wahudson/piezo_ac_drive/kicad/v5/v5.pdf

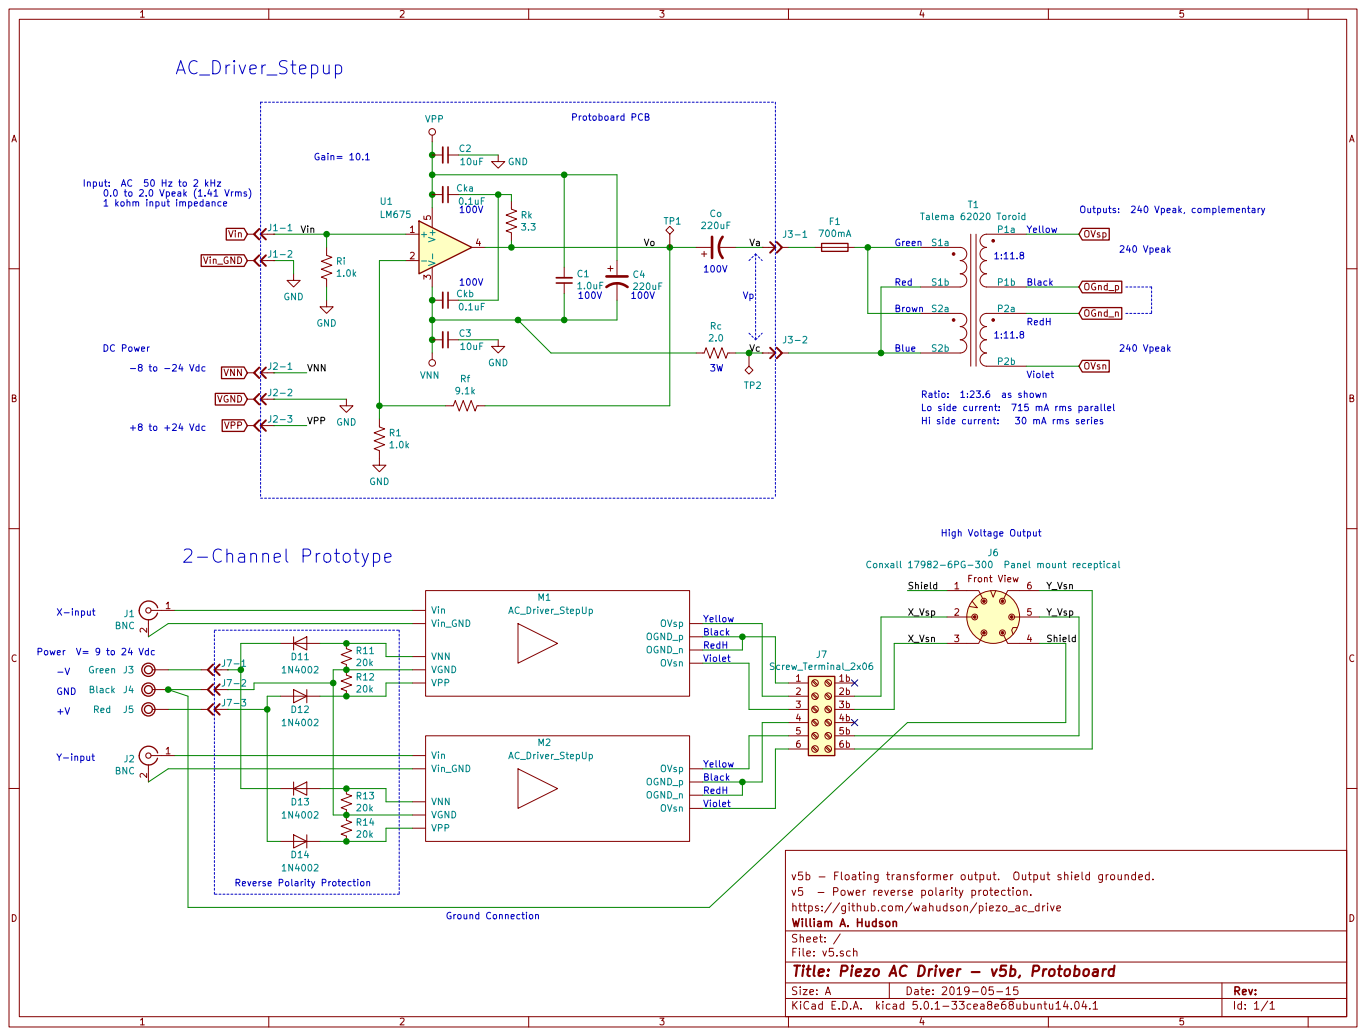
[picture p1: page 1]

Input: AC 50 Hz to 2 kHz
0.0 to 2.0 Vpeak (1.41 Vrms)
1 kohm input impedance

Violet Green Red Brown Blue Cka

Lo side current: 715 mA rms parallel

v5b - Floating transformer output. Output shield grounded.
v5 - Power reverse polarity protection.
https://github.com/wahudson/piezo_ac_drive
File: v5.sch Sheet: / William A. Hudson

Id: 1/1 Title: Piezo AC Driver - v5b, Protoboard
