wahudson/piezo_ac_drive/kicad/v4/v4.pdf

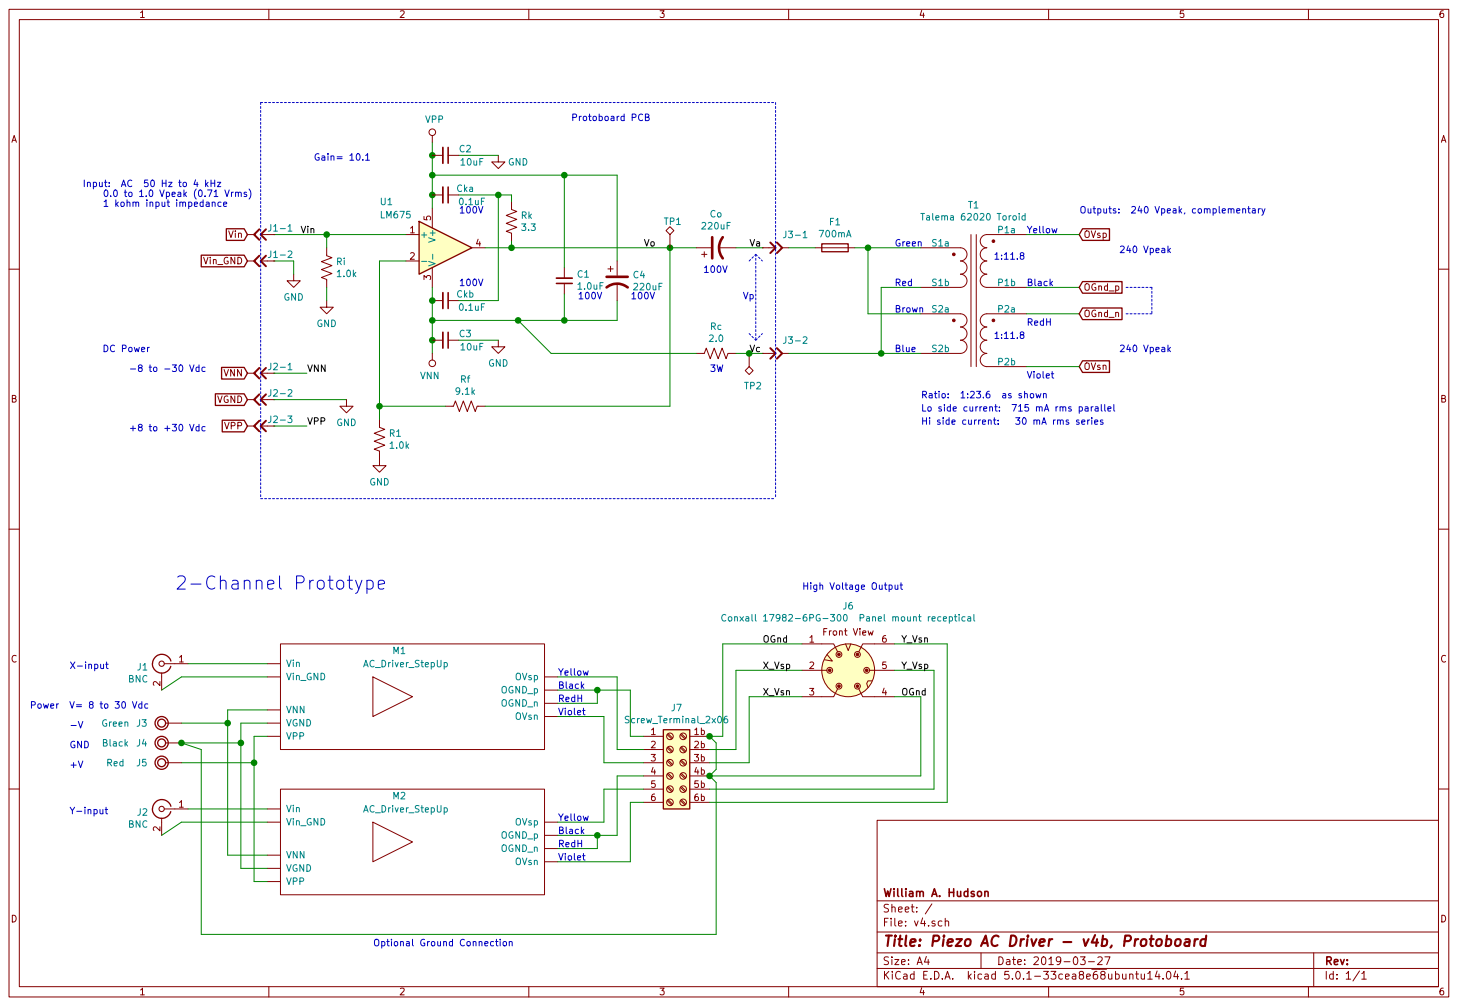
[picture p2: page 1]

Input: AC 50 Hz to 4 kHz
0.0 to 1.0 Vpeak (0.71 Vrms)
1 kohm input impedance

Violet Green Red Brown Blue Cka

Lo side current: 715 mA rms parallel

File: v4.sch Sheet: / William A. Hudson

Id: 1/1 Title: Piezo AC Driver - v4b, Protoboard
