wahudson/piezo_ac_drive/kicad/v5/v5.sch

## KiCad design kicad/v5/v5.sch (2019-05-16)

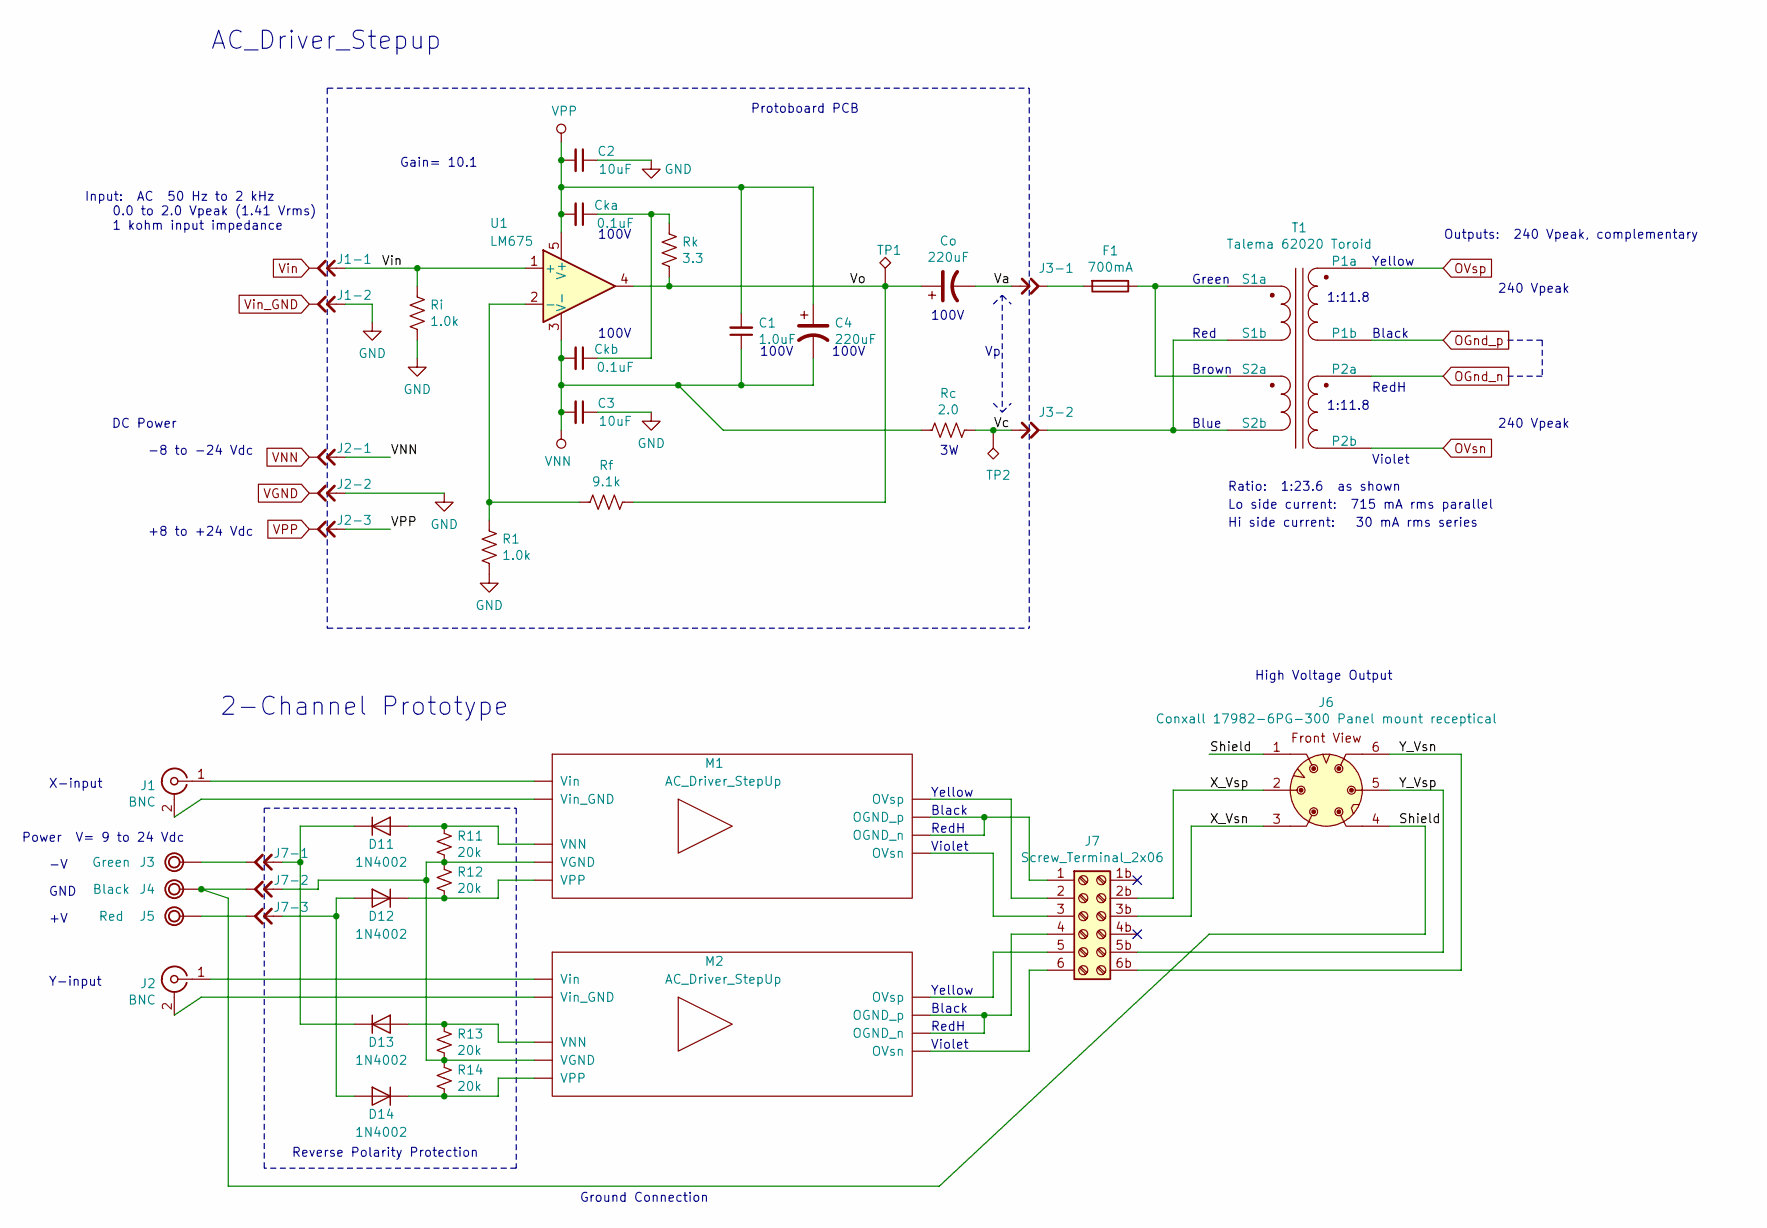
[picture p3: schematic v5.sch]

Parts:
C1: 1.0uF
C2, C3: 10uF
C4: 220uF
Cka: 0.1uF
Ckb: 0.1uF
Co: 220uF
D11, D12, D13, D14: 1N4002; D_DO-41_SOD81_P10.16mm_Horizontal
F1: 700mA
J1, J2: BNC
J1-1, J1-2, J2-1, J2-2, J2-3, J3-1, J3-2, J7-1, J7-2, J7-3: Head1_1
J3: Green
J4: Black
J5: Red
J6: Conxall 17982-6PG-300 Panel mount receptical
J7: Screw_Terminal_2x06
M1, M2: AC_Driver_StepUp
R1: 1.0k
R11, R12, R13, R14: 20k
Rc: 2.0
Rf: 9.1k
Ri: 1.0k
Rk: 3.3
T1: Talema 62020 Toroid
TP1, TP2: TestPoint_Alt
U1: LM675; TO-220-5_P3.4x3.7mm_StaggerOdd_Lead3.8mm_Vertical

Connections:
GND: C2.1, C3.1, J1-2.1 (A), J2-2.1 (A), R1.2, Ri.2
unnamed: Cka.1, Ckb.1, Rk.1
unnamed: D11.1 (K), D13.1 (K), J7-1.1 (A)
unnamed: D11.2 (A), M1.31 (VNN), R11.1
unnamed: D12.1 (K), M1.33 (VPP), R12.2
unnamed: D12.2 (A), D14.2 (A), J7-3.1 (A)
unnamed: D13.2 (A), M2.31 (VNN), R13.1
unnamed: D14.1 (K), M2.33 (VPP), R14.2
unnamed: F1.1, T1.5 (S1a), T1.7 (S2a)
unnamed: F1.2, J3-1.2 (B)
unnamed: J1.1 (In), M1.11 (Vin)
unnamed: J1.2 (Ext), M1.12 (Vin_GND)
unnamed: J2.1 (In), M2.11 (Vin)
unnamed: J2.2 (Ext), M2.12 (Vin_GND)
unnamed: J3-2.2 (B), T1.6 (S1b), T1.8 (S2b)
unnamed: J3.1, J7-1.2 (B)
unnamed: J5.1, J7-3.2 (B)
unnamed: J7-2.1 (A), M1.32 (VGND), M2.32 (VGND), R11.2, R12.1, R13.2, R14.1
unnamed: J7.1, M1.22 (OGND_n), M1.~ (OGND_p)
unnamed: J7.2, M1.21 (OVsp)
unnamed: J7.3, M1.23 (OVsn)
unnamed: J7.4, M2.22 (OGND_n), M2.~ (OGND_p)
unnamed: J7.5, M2.21 (OVsp)
unnamed: J7.6, M2.23 (OVsn)
unnamed: R1.1, Rf.2, U1.2 (-)
OGnd_n: T1.3 (P2a)
OGnd_p: T1.2 (P1b)
OVsn: T1.4 (P2b)
OVsp: T1.1 (P1a)
Shield: J4.1, J6.1 (p1), J6.4 (p4), J7-2.2 (B)
VGND: J2-2.2 (B)
VNN: C1.1, C3.2, C4.2, Ckb.2, J2-1.1 (A), J2-1.2 (B), Rc.2, U1.3 (V-)
VPP: C1.2, C2.2, C4.1, Cka.2, J2-3.1 (A), J2-3.2 (B), U1.5 (V+)
Va: Co.2, J3-1.1 (A)
Vc: J3-2.1 (A), Rc.1, TP2.1
Vin: J1-1.1 (A), J1-1.2 (B), Ri.1, U1.1 (+)
Vin_GND: J1-2.2 (B)
Vo: Co.1, Rf.1, Rk.2, TP1.1, U1.4
X_Vsn: J6.3 (p3), J7.3b
X_Vsp: J6.2 (p2), J7.2b
Y_Vsn: J6.6 (p6), J7.6b
Y_Vsp: J6.5 (p5), J7.5b

Notes on the sheet:
Yellow
Black
RedH
Violet
Green
Red
Brown
Blue
1:11.8
+8 to +24 Vdc
-8 to -24 Vdc
100V
DC Power
Protoboard PCB
X-input
Y-input
GND
High Voltage Output
2-Channel Prototype
Power V= 9 to 24 Vdc
Outputs: 240 Vpeak, complementary
Ratio: 1:23.6 as shown
Gain= 10.1
Input: AC 50 Hz to 2 kHz 0.0 to 2.0 Vpeak (1.41 Vrms) 1 kohm input impedance
Lo side current: 715 mA rms parallel
240 Vpeak
Hi side current: 30 mA rms series
Ground Connection
Reverse Polarity Protection
AC_Driver_Stepup
