wahudson/piezo_ac_drive/(commit log)

2019-02-02 Checkpoint: Kicad schematic version 4 - solder protoboard.
    [v4.sch]
2019-02-17 Schematic: Add "100V" note to compensation capacitors Cka, Ckb. Move U1 LM675 note location.
    [v4.sch]
2019-02-17 Schematic: Rename (reorder) power terminals to match the "as-built" board, putting the negative supply first.
    [v4.sch]
2019-02-18 Schematic: Add input/output notes and transformer rating.
    [v4.sch]
2019-03-31 Schematic: Version v4b. Add test points on op-amp output Vo and current measuring resistor Vc. Add PDF in Git, to help people looking at repository.
    [v4.sch]
2019-04-09 Schematic: Version v5. Added Reverse Polarity Protection on power supply inputs.
    [v5.sch]
2019-04-09 Schematic: Revise input and power notes for operating range.
    [v5.sch]
2019-05-16 Schematic: v5 change paper size to 8.5x11. Move the whole "2-Channel Prototype" to better fit the page. No content changes.
    [v5.sch]
2019-05-16 Schematic: v5b - Floating transformer output. Output connector shield is grounded on pin 4.
    [v5.sch]
2019-05-21 Doc: User Guide for Piezo AC Driver v5b. Added detail guidelines.
2019-05-22 Doc: Bill of Material - Piezo AC Driver v4
2019-08-29 Doc: Power supply design. Initial ideas.
